bytesizedengineering/Openwheel/Mechanical Design/STL Files/front enclosure.stl

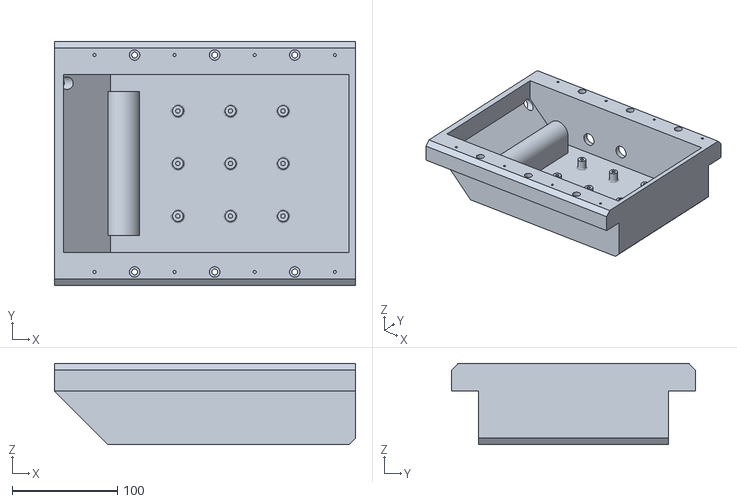
[picture p2: CAD file, 2021-08-20]
Mechanical Design/STL Files/front enclosure.stl
286.4 x 231.8 x 77.1
