bytesizedengineering/Openwheel/Mechanical Design/STL Files/rear footpad.stl

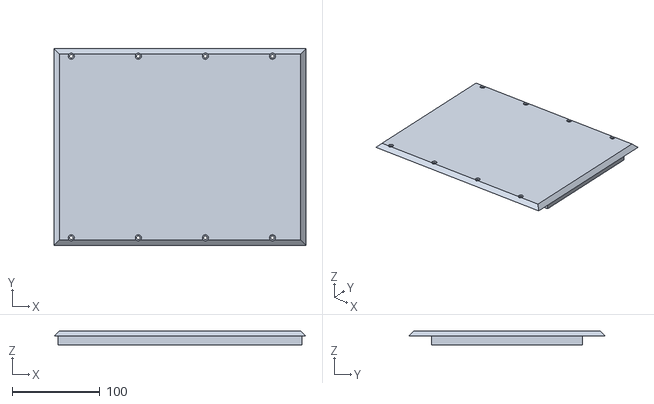
[picture p3: CAD file, 2021-07-20]
Mechanical Design/STL Files/rear footpad.stl
286.4 x 223.8 x 16.0
