bytesizedengineering/Openwheel/Mechanical Design/STL Files/front footpad.stl

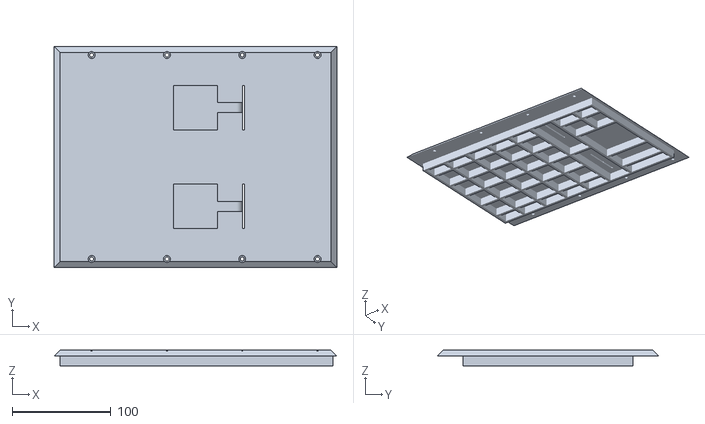
[picture p4: CAD file, 2021-07-20]
Mechanical Design/STL Files/front footpad.stl
286.4 x 223.8 x 16.0
