bytesizedengineering/Openwheel/Mechanical Design/STL Files/electronics platform.stl

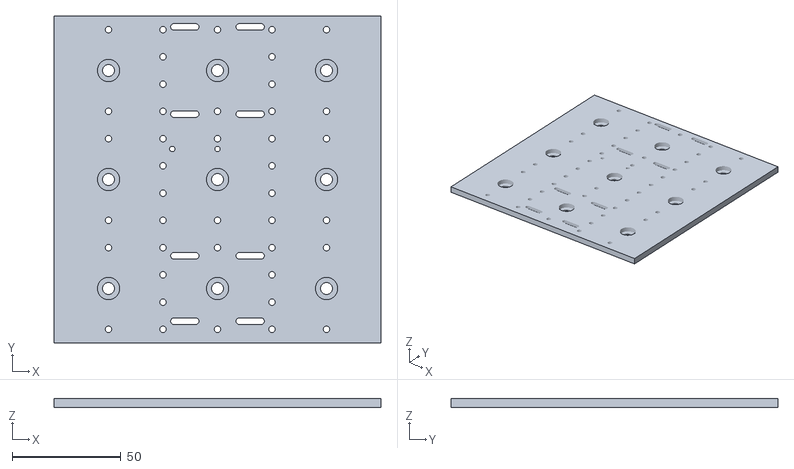
[picture p5: CAD file, 2021-07-20]
Mechanical Design/STL Files/electronics platform.stl
150.0 x 150.0 x 4.00
