bytesizedengineering/Openwheel/Mechanical Design/STL Files/front bumper.stl

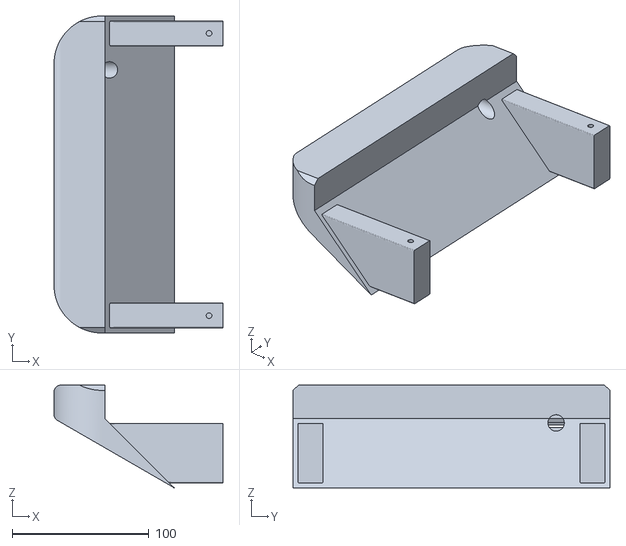
[picture p6: CAD file, 2021-07-20]
Mechanical Design/STL Files/front bumper.stl
123.6 x 231.8 x 75.1
