bytesizedengineering/Openwheel/Electrical Design/Openwheel.pdf

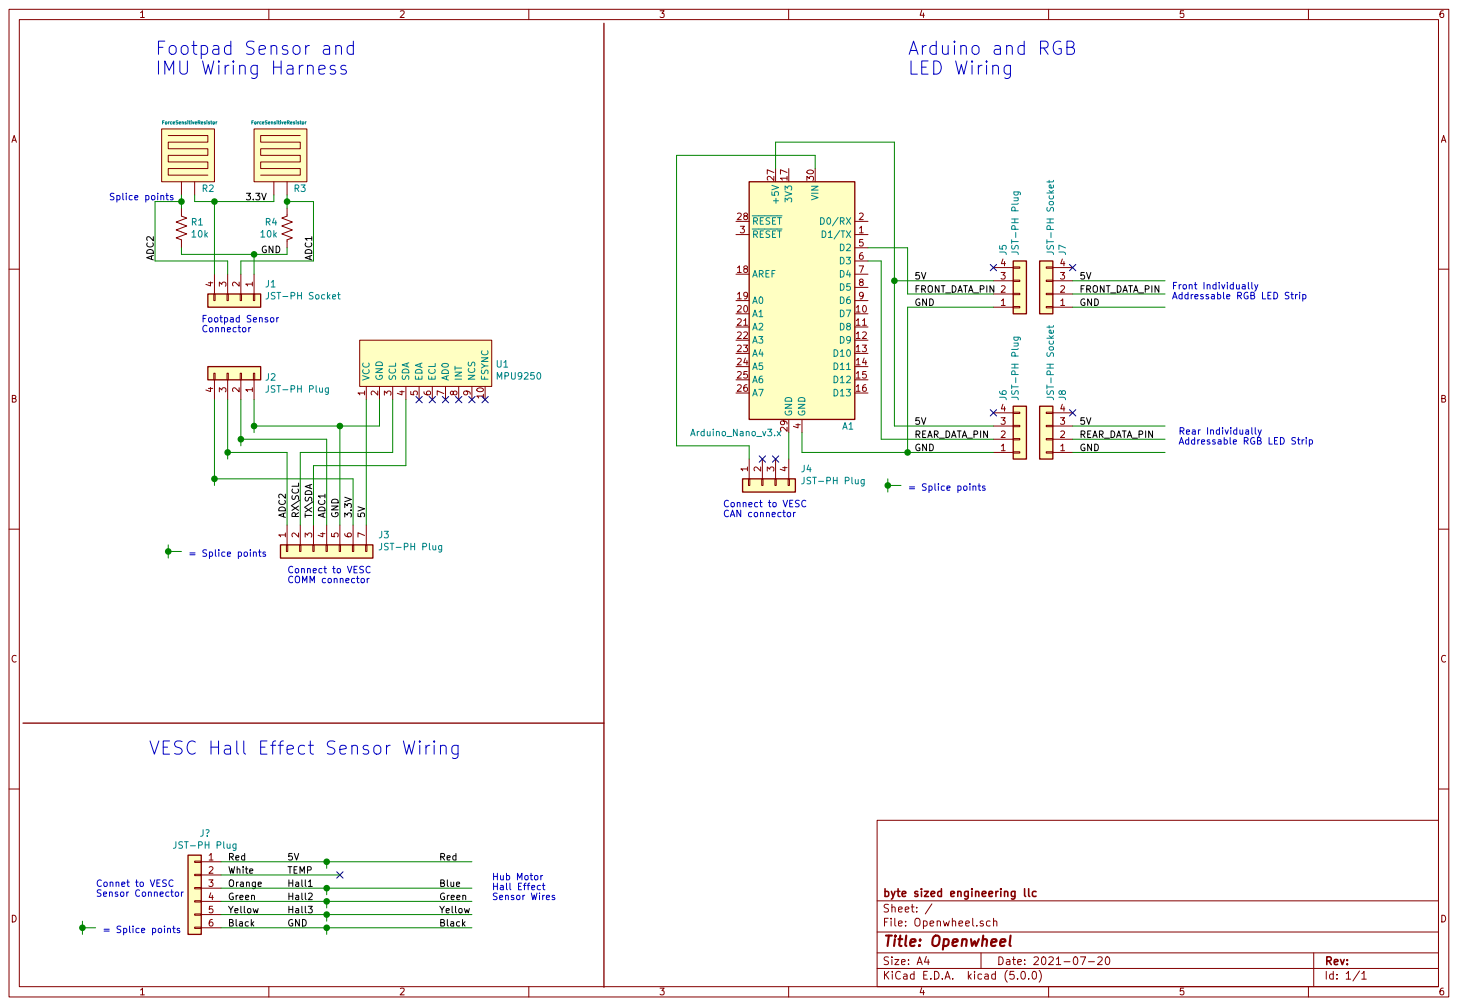
[picture p8: page 1]

9 U1MPU9250 ADC2 RX\SCL TX\SDA ADC1 GND 3.3V 5V D1/TX 1 D7 10 D8 11 D9 12 D10 13 D11 14 D12 15 D13 16 3V3 17 AREF 18 A0 19 D0/RX 2 A1 20 A2 21 A3 22 A4 23 A5 24 A6 25 A7 26 +5V 27 RESET 28 GND 29 RESET 3 VIN 30 GND

JST-PH Plug VCC

Front Individually
Addressable RGB LED Strip

VESC Hall Effect Sensor Wiring

TEMP Connet to VESC

File: Openwheel.sch Sheet: / byte sized engineering llc
