bytesizedengineering/Openwheel/Mechanical Design/Openwheel - Drawing.pdf

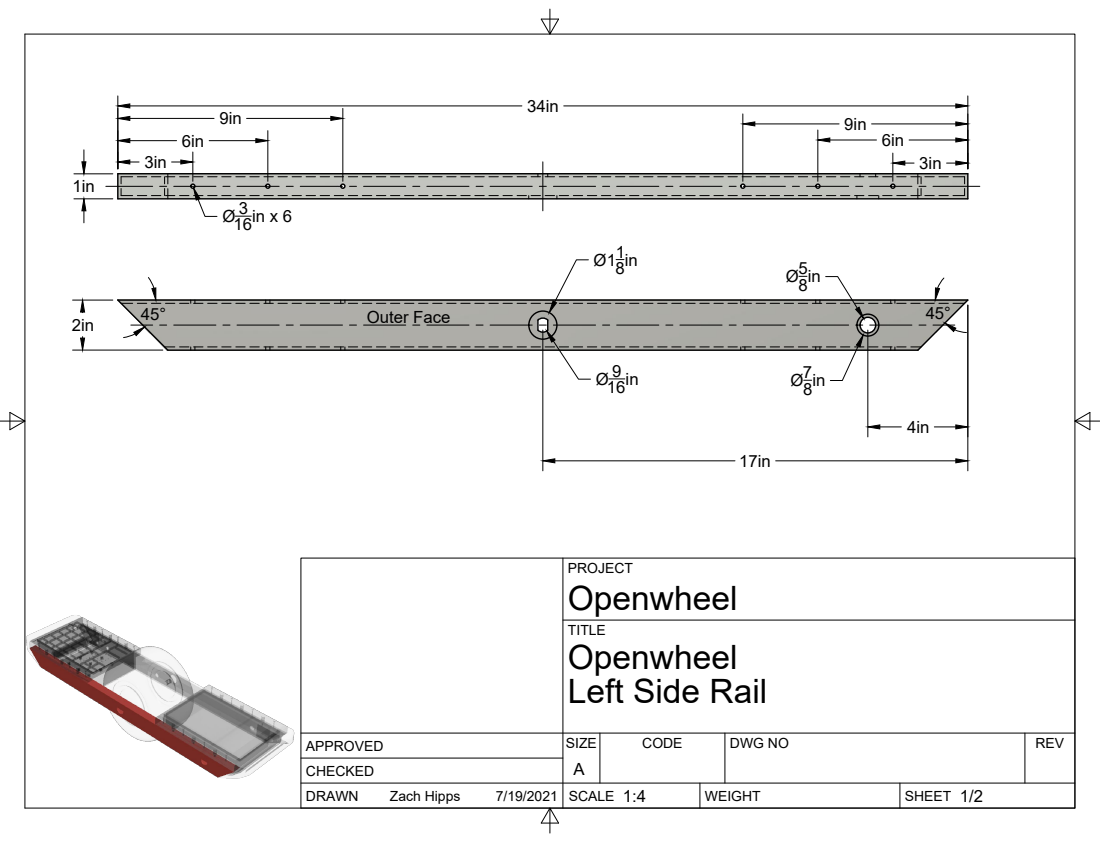
[picture p9: page 1]
SIZE; CODE; DWG NO; REV; Zach Hipps; Outer Face

PROJECT
Openwheel
Left Side Rail

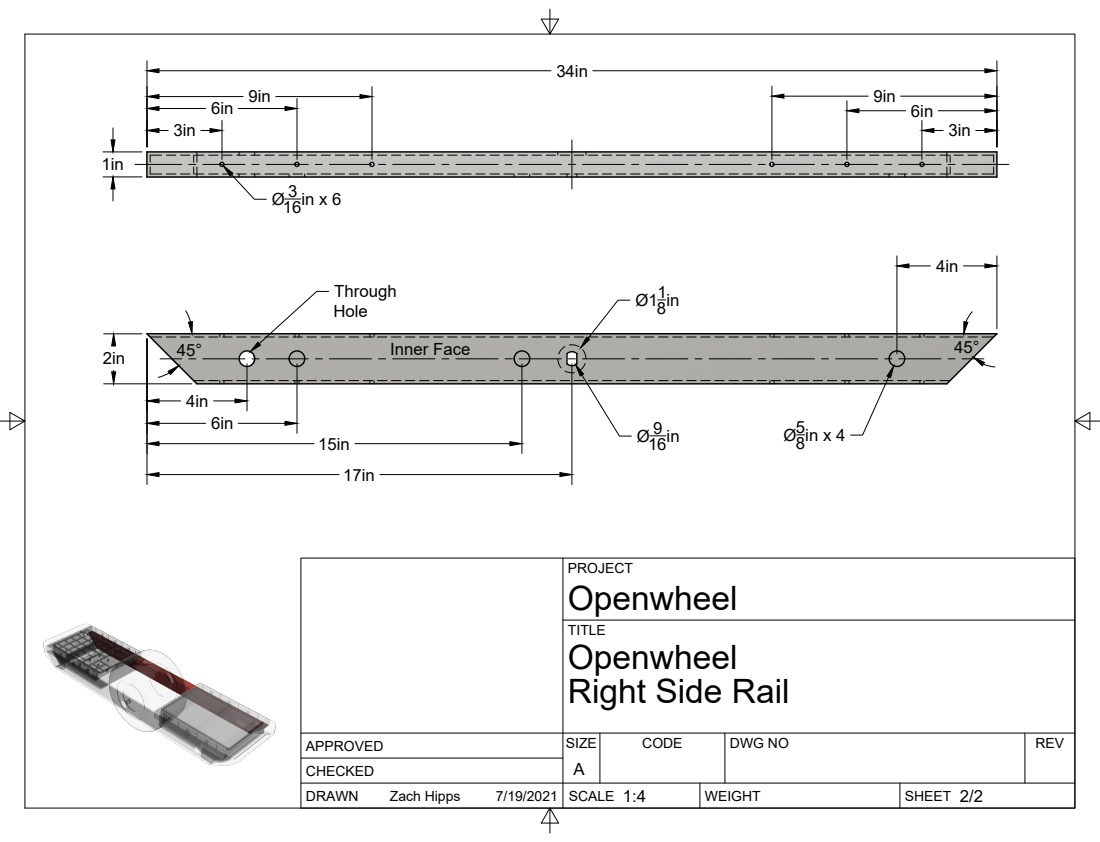
[picture p10: page 2]
SIZE; CODE; DWG NO; REV; Zach Hipps; Inner Face

PROJECT
Openwheel
Right Side Rail
