bytesizedengineering/Openwheel/(commit log)

2021-07-16 Organized file structure
    [OpenWheel v52.step, electronics platform.stl, front bumper.stl, front enclosure.stl, front footpad.stl, rear bumper.stl, rear enclosure.stl, rear footpad.stl]
2021-07-16 added gitignore
    [Openwheel VESC App Config.xml, Openwheel VESC Motor Config.xml]
2021-07-19 Updated documents
    [OpenWheel v52.step]
2021-07-20 Added Electrical Design
    [Openwheel.kicad_pcb, Openwheel.sch, electronics platform.stl, front bumper.stl, front enclosure.stl, front footpad.stl, rear bumper.stl, rear enclosure.stl]
2021-07-21 Updated documentation
    [Openwheel.sch]
2021-08-20 Increased Enclosure Wall Thickness
    Updated Folder Names and increased enclosure wall thickness
    [Openwheel VESC App Config.xml, Openwheel VESC Motor Config.xml, electronics platform.stl, front bumper.stl, front enclosure.stl, front footpad.stl, rear bumper.stl, rear enclosure.stl]
